Helix99/AA-NODE/Schematic.pdf

# 2 JP1¹

# VCC VCC

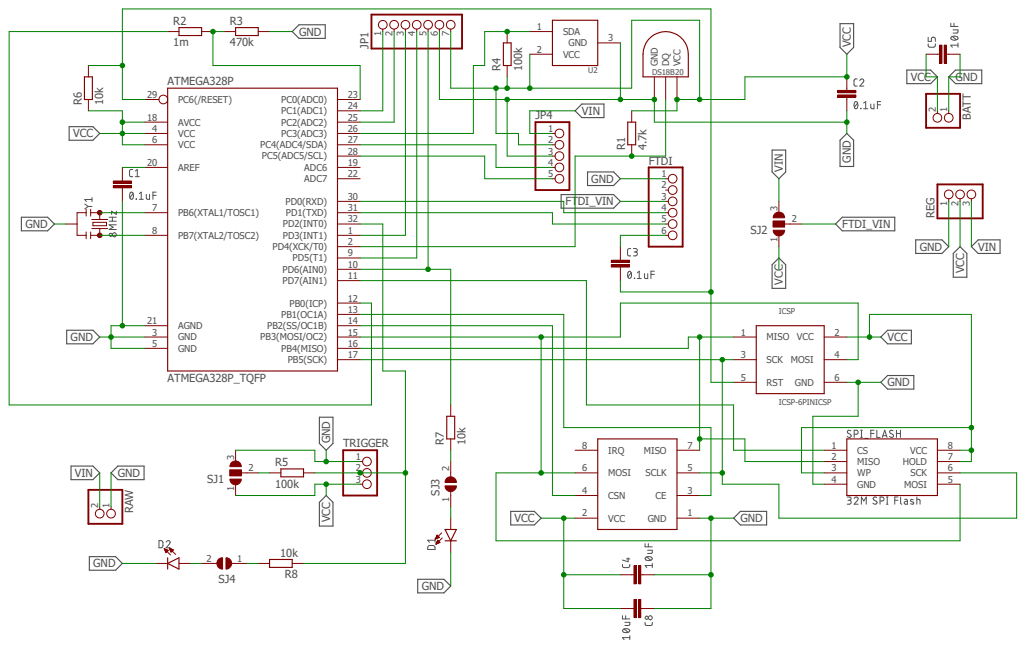
[picture p1: page 1]
ATMEGA328P_TQFP; ICSP-6PINICSP ⁴.7k; 100k ¹⁰k; ATMEGA328P; PB5(SCK); PB7(XTAL2/TOSC2) 8; PB6(XTAL1/TOSC1) 7; GND 3 GND 5; VCC 4 VCC 6; AGND 21; AREF 20; AVCC 18; PB4(MISO); 16 PB3(MOSI/OC2); 13 PB0(ICP); PD7(AIN1); 11 PD6(AIN0); PD4(XCK/T0); PD3(INT1); PD2(INT0); 32 PD1(TXD); 31 PD0(RXD); ADC7; 22 ADC6; 19 PC5(ADC5/SCL); 28 PC4(ADC4/SDA); 27 PC3(ADC3); 26 PC2(ADC2); 25 PC1(ADC1); 24 PC0(ADC0); 23 PC6(/RESET) 29; BATT 2; MISO 1; VCC; SCK 3; MOSI; RST 5; GND; ICSP; FTDI 1 2 3 4 5; 6 REG1 2; SCLK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

DS18B20 GND DQVCC R¹
