Helix99/AA-NODE/Examples/AA_NODE_NODEMANAGER/AA_NODE_NODEMANAGER.ino

/*
NodeManager is intended to take care on your behalf of all those common tasks a MySensors node has to accomplish, speeding up the development cycle of your projects.
NodeManager includes the following main components:
- Sleep manager: allows managing automatically the complexity behind battery-powered sensors spending most of their time sleeping
- Power manager: allows powering on your sensors only while the node is awake
- Battery manager: provides common functionalities to read and report the battery level
- Remote configuration: allows configuring remotely the node without the need to have physical access to it
- Built-in personalities: for the most common sensors, provide embedded code so to allow their configuration with a single line 
Documentation available on: https://github.com/mysensors/NodeManager


AA NODE NodeManager Temprature Example

Send temprature and battery every 15 mins
*/

 
// load user settings
#include "config.h"
// include supporting libraries
#ifdef MY_GATEWAY_ESP8266
  #include <ESP8266WiFi.h>
#endif
// load MySensors library
#include <MySensors.h>
// load NodeManager library
#include "NodeManager.h"

// create a NodeManager instance
NodeManager nodeManager;

// before
void before() {
  // setup the serial port baud rate
  Serial.begin(MY_BAUD_RATE);  

  /*
   * Register below your sensors
  */
  nodeManager.setBatteryMin(1.8);
  nodeManager.setBatteryMax(3.1);
  nodeManager.setBatteryPin(0);
  nodeManager.setBatteryReportMinutes(15);
  
  nodeManager.setSleepMinutes(15);
  nodeManager.setReportIntervalMinutes(15);
  
  nodeManager.registerSensor(SENSOR_DS18B20,4);
  #if POWER_MANAGER == 1
    nodeManager.setPowerPins(-1,8,50);
  #endif
  /*
   * Register above your sensors
  */
  nodeManager.before();
}

// presentation
void presentation() {
  // call NodeManager presentation routine
  nodeManager.presentation();
}

// setup
void setup() {
  // call NodeManager setup routine
  nodeManager.setup();
}

// loop
void loop() {
  // call NodeManager loop routine
  nodeManager.loop();
}

// receive
void receive(const MyMessage &message) {
  // call NodeManager receive routine
  nodeManager.receive(message);
}

// receiveTime
void receiveTime(unsigned long ts) {
  // call NodeManager receiveTime routine
  nodeManager.receiveTime(ts);
}
